livingphysics/quarto_notes/docs/tech_posts/proj_operator/thumbnail.png

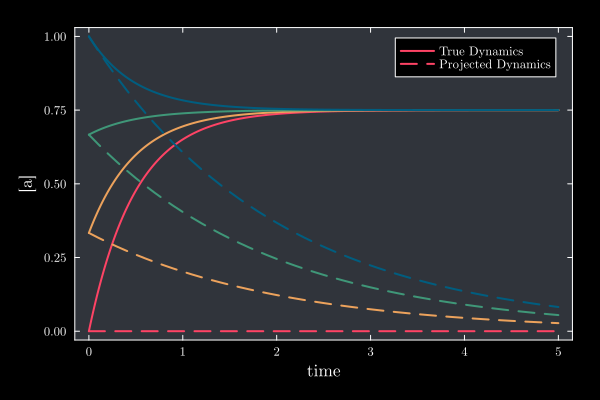
docs/tech_posts/proj_operator/thumbnail.png
