livingphysics/quarto_notes/docs/tech_posts/sloppy_projection/thumbnail.png

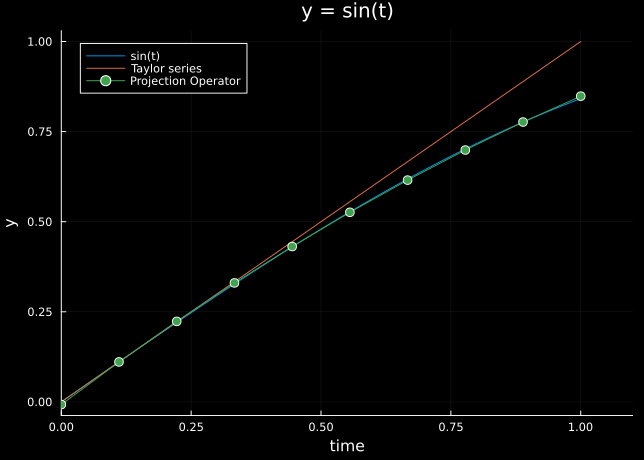
docs/tech_posts/sloppy_projection/thumbnail.png
