livingphysics/quarto_notes/docs/tech_posts/TAI/thumbnail.png

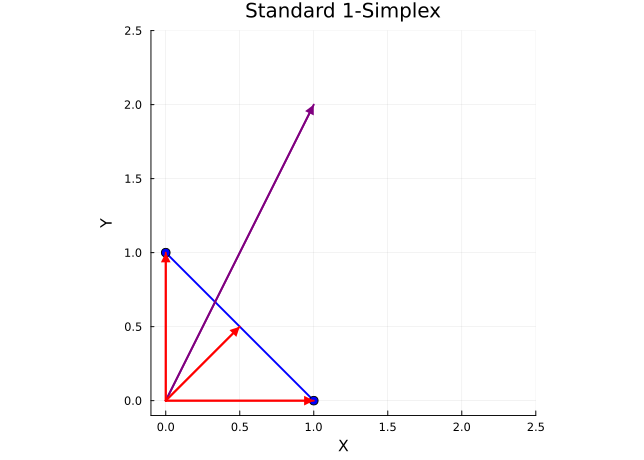
docs/tech_posts/TAI/thumbnail.png
