livingphysics/quarto_notes/build_posts/gen3_reactor_build/files/HeatingBlock_New v5.stl

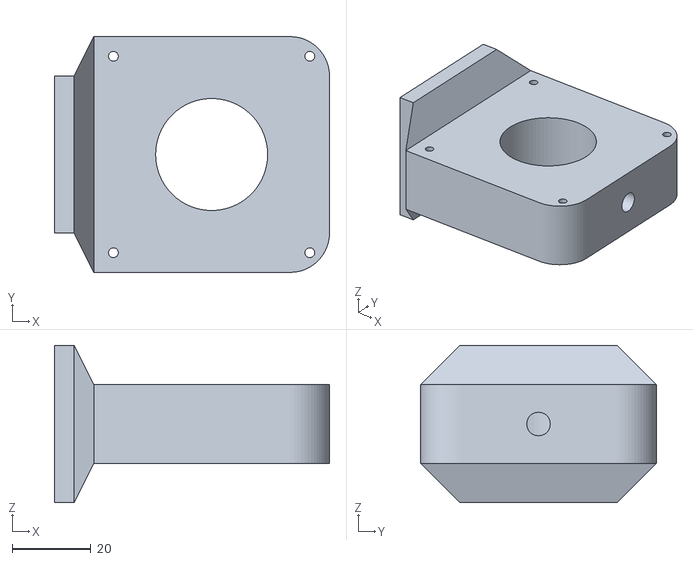
[picture p9: CAD file, 2026-04-27]
build_posts/gen3_reactor_build/files/HeatingBlock_New v5.stl
70.0 x 60.0 x 40.0
