livingphysics/quarto_notes/docs/build_posts/gen3_reactor_build/files/pio_adaptor.stl

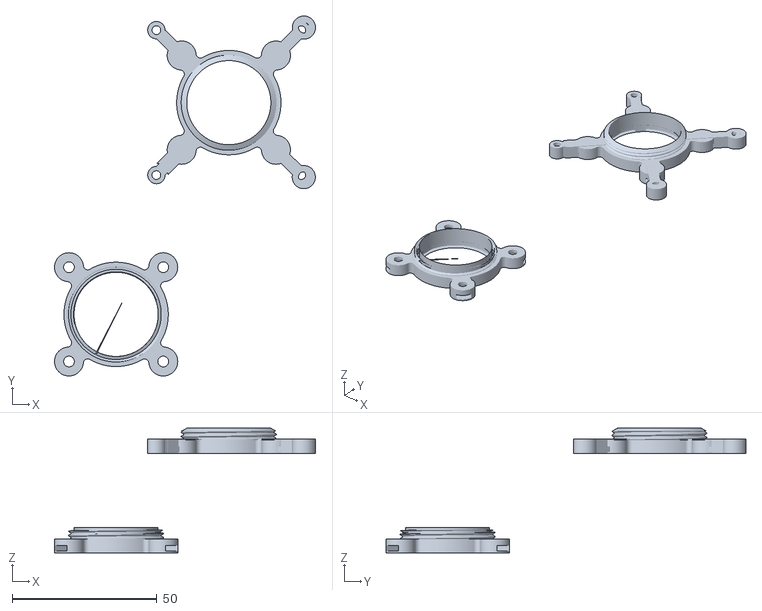
[picture p10: CAD file, 2026-04-28]
docs/build_posts/gen3_reactor_build/files/pio_adaptor.stl
90.0 x 124.2 x 43.0
