livingphysics/quarto_notes/build_posts/gen3_reactor_build/files/Atlas-T-Cap.stl

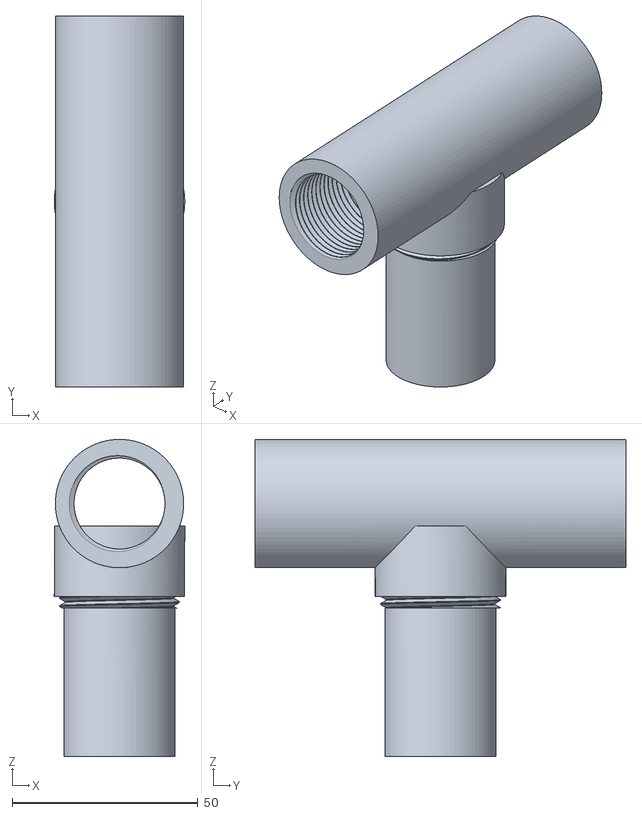
[picture p11: CAD file, 2026-04-15]
build_posts/gen3_reactor_build/files/Atlas-T-Cap.stl
35.2 x 100.0 x 85.5
