livingphysics/quarto_notes/build_posts/gen3_reactor_build/files/AtlasCapSingle.stl

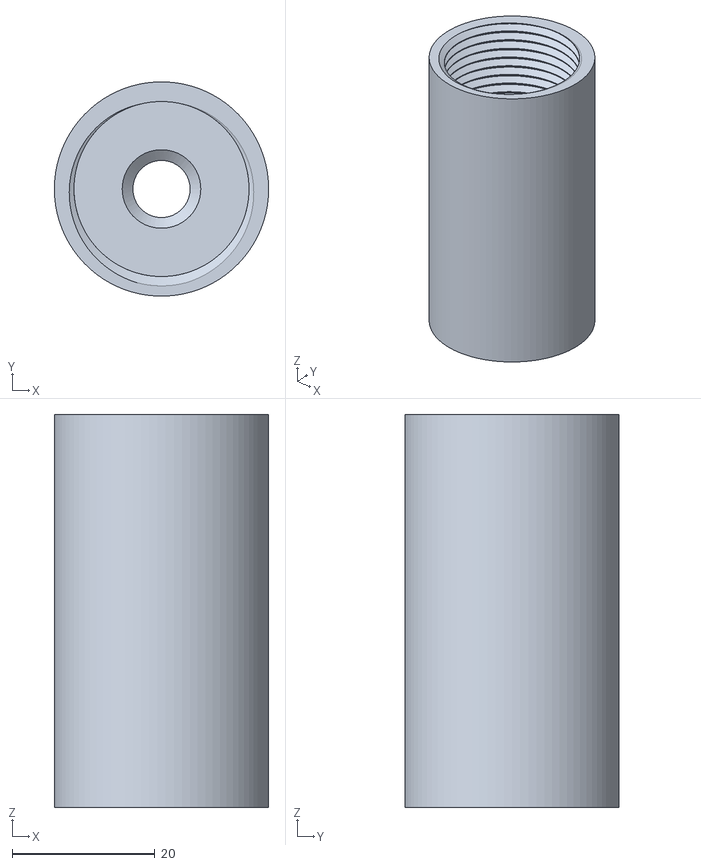
[picture p12: CAD file, 2026-04-15]
build_posts/gen3_reactor_build/files/AtlasCapSingle.stl
30.0 x 30.0 x 55.0
