livingphysics/quarto_notes/docs/builds.html

# Build Notes

##### Categories

All (6)

Bioreactor (4)

Builds (6)

Notes (2)

Yeast (1)



### Third Generation Bioreactor Build Note

Builds

Bioreactor

The bioreactor has been redesigned as single modular units instead of the four bioreactor units that I was designing before. This is to facilitate individual temperature and…

Apr 16, 2026

David Jordan



### Second Generation Bioreactor Build

Builds

Bioreactor

This note outlines the build of our second generation bioreactor. This version of the bioreactor includes Temperature Control and a Pump System for exchanging media. It can…

Sep 9, 2025

David Jordan, Somsubhro Bagchi



### Recreating the Gal-His yeast system used to demonstrate adaptive reprogramming

Builds

Notes

Yeast

A goal for the future would be to determine the extent of knowledge the cell has of itself and how it uses that knowledge in a thoughtful manner when challenged.

Feb 28, 2025

David Jordan, Mihoko Tame



### First Generation Bioreactor Update

Builds

Bioreactor

This note describes an upgrade to the first generation bioreactor to increase the sensitivity and long-term reliability of the optical density measurements. The optical…

Feb 18, 2025

David Jordan, Somsubhro Bagchi

### How I Built This Quarto Notes Site

Builds

Notes

This note describes how I set up and hosted this quarto notes site on the notes.x subdomain of my domain livingphysics.org. To do this I run quarto locally in Visual Studio…

Sep 19, 2024

David Jordan



### First Generation Bioreactor Build Note

Builds

Bioreactor

This note describes the design and construction of a RaspberryPi based 4-bioreactor system that has external illumination, external temperature recording, and magnetic…

Sep 18, 2024

David Jordan, Michele Cespa

No matching items
