livingphysics/quarto_notes/docs/results_posts/cell_learning_2509/thumbnail.png

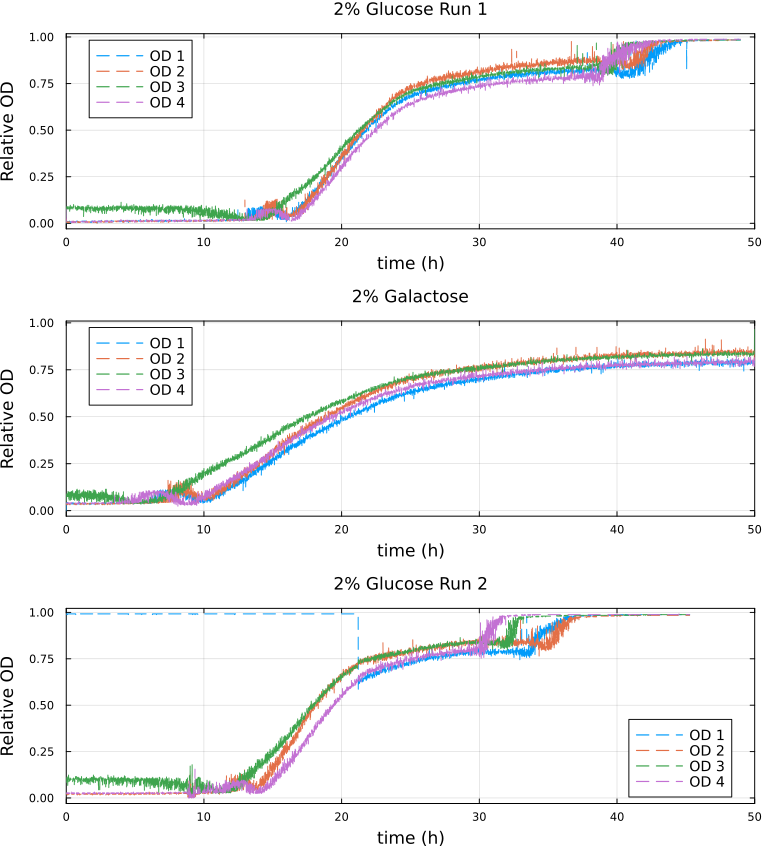
docs/results_posts/cell_learning_2509/thumbnail.png
