livingphysics/quarto_notes/(commit log)

2026-04-15 gen3 work
    [Atlas-T-Cap.stl, AtlasCapSingle.stl]
2026-04-16 third gen bioreactor build
    [Atlas-T-Cap.stl, AtlasCapSingle.stl]
2026-04-27 heating block stl
    [HeatingBlock_New v5.stl]
2026-04-28 added correct STL files
    [pio_adaptor.stl]
2026-04-28 STL file link
    [pio_adaptor.stl]
